jvn1228/sony_tally_light/stls/tally_base-v2.stl

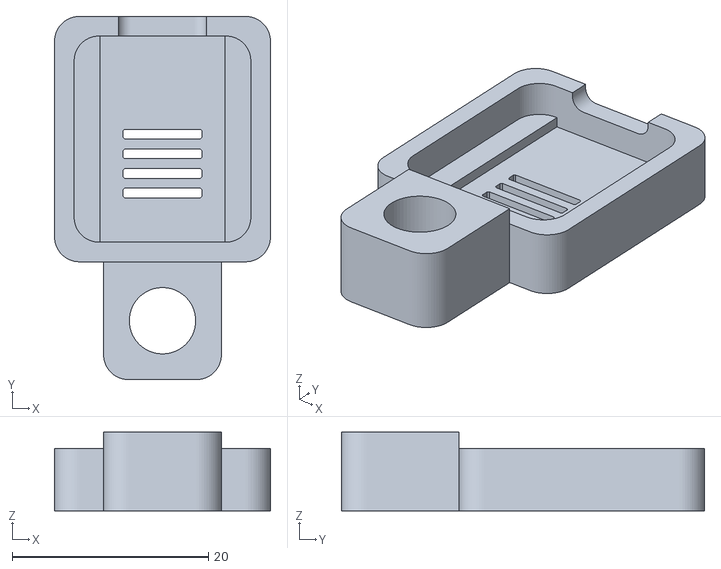
[picture p3: CAD file, 2026-10-17]
stls/tally_base-v2.stl
22.0 x 37.0 x 8.00
