jvn1228/sony_tally_light/stls/transparent-cap_v2.stl

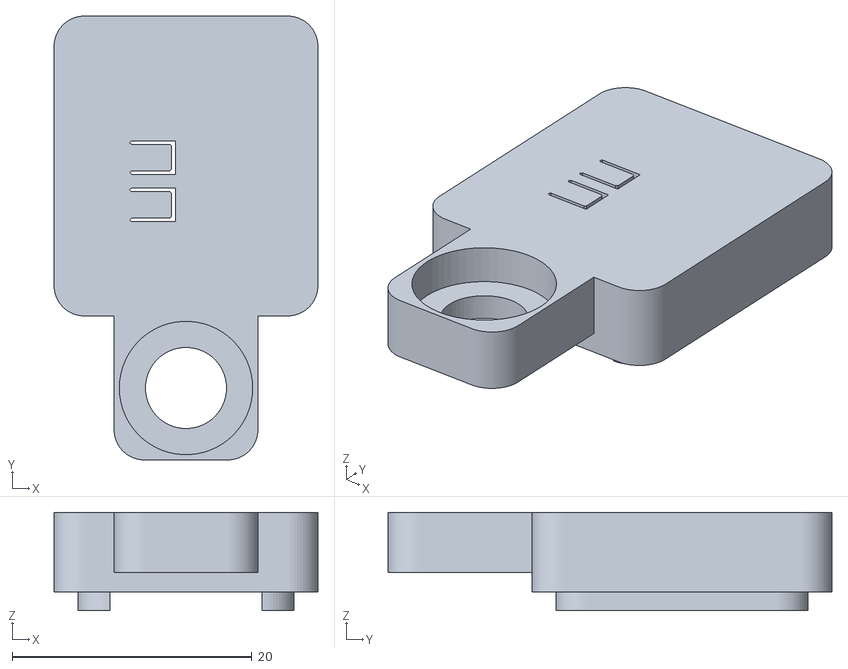
[picture p4: CAD file, 2026-10-17]
stls/transparent-cap_v2.stl
22.0 x 37.0 x 8.20
